thefengML/embedded/README.md

# embedded

Projects related to embedded systems.

## Contents

| Project | Description |
|---|---|
| [smart-luggage](smart-luggage/) | 智能行李箱 / Intelligent luggage — STM32F103C8 + FreeRTOS V11.1.0 |

## Note on credentials

No credentials are stored in this repository. Before building a project, copy its
`secrets.h.example` to `secrets.h` and fill in your own settings.
