thefengML/embedded/smart-luggage/原理图/SCH_Schematic1.pdf

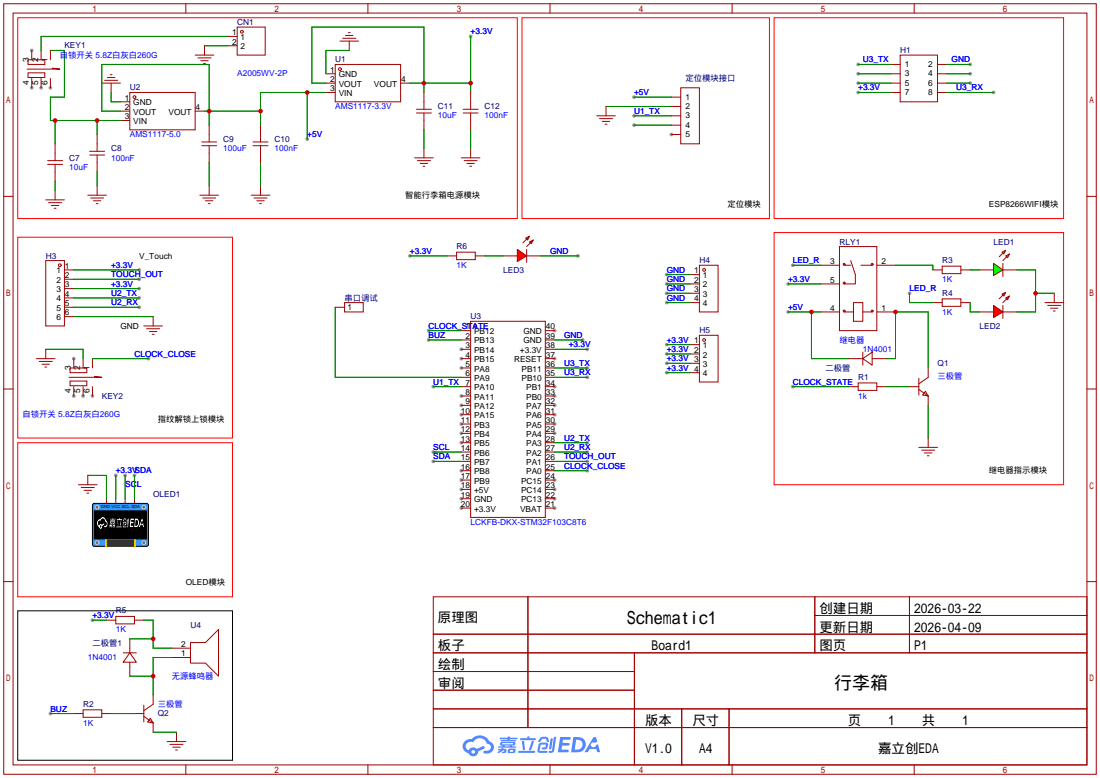
[picture p1: page 1]

GND VCC SCL SDA

原理图 | Schematic1 | 创建日期 | 2026-03-22

更新日期 | 2026-04-09

板子 | Board1 | 图页 | P1
绘制 | | 行李箱
审阅

V1.0 | A4 | 嘉立创EDA
