thefengML/embedded/smart-luggage/module/WIFI_Command.h

#ifndef _WIFI_COMMAND_H
#define _WIFI_COMMAND_H

/* WIFI_Command.h —— 集中声明各条 AT 指令字符串（定义在 WIFI_Command.c）。
。 */

extern const char AT[];
extern const char ATE0[];
extern const char Station[];

extern const char CWJAP[];
extern const char CIFSR[];
extern const char CWLLAP[];
extern const char MQTTUSERCFG[];
extern const char MQTTCONN[];
extern const char MQTTSUB[];
extern const char MQTTSUB_CMD[];

#endif
