thefengML/embedded/(commit log)

2026-10-14 Initial commit: smart-luggage (STM32F103 + FreeRTOS)
2026-10-14 docs: add Chinese README and language switcher
2026-10-14 docs: rewrite README as engineering spec (features / task flow / layering)
2026-10-15 chore: sync source with latest project changes
    - lock / alarm / WIFI / BUZ / Uart / ZW101 / key modules updated
    - removed secrets.h.example and ZW101_Command.h (no longer referenced)
    - updated .uvprojx and .uvoptx
    [BUZ.c, Uart.c, WIFI.c, WIFI_Command.h, ZW101.c, ZW101.h, alarm.h, key.c]
2026-10-15 docs: 统一注释与 README 的表述
    - alarm.h：断连告警开关的理由改为设计层表述（与远程 BUZ 共用蜂鸣器）
    - main.c：栈余量依据、钩子启用理由改为通用说法
    - WIFI.c：转义序列保留理由去掉环境相关措辞
    - README：ALARM_ENABLE_LINK_ALARM 说明改为「默认关闭」
